FahimAhmad-BD/duccky/analysis/mass/mass_report.md

| Group | Mass (g) |
|---|---|
| servo | 300 |
| printed | 267 |
| allocation | 165 |
| cell | 92 |
| spring | 6 |
| **Total** | **831** |

| Link | Mass (g) |
|---|---|
| trunk | 385.3 |
| head | 81.5 |
| head_pitch_link | 49.9 |
| L_foot | 35.8 |
| R_foot | 35.8 |
| L_hip_roll_link | 32.2 |
| R_hip_roll_link | 32.2 |
| L_thigh | 31.3 |
| R_thigh | 31.3 |
| head_yaw_link | 24.9 |
| L_hip_yaw_link | 24.2 |
| R_hip_yaw_link | 24.2 |
| L_shank | 13.5 |
| R_shank | 13.5 |
| mandible | 8.0 |
| neck_link | 6.9 |

| Printed part | Solid (g) | Printed (g) |
|---|---|---|
| head_shell | 51.5 | 51.5 |
| trunk_frame | 47.5 | 47.5 |
| cartridge_lid | 15.5 | 15.5 |
| cartridge_tray | 15.1 | 15.1 |
| head_base | 13.9 | 13.9 |
| foot_L | 13.0 | 12.8 |
| foot_R | 13.0 | 12.8 |
| shank_L | 10.3 | 10.3 |
| shank_R | 10.3 | 10.3 |
| roll_link_L | 9.2 | 9.2 |
| roll_link_R | 9.2 | 9.2 |
| thigh_L | 8.3 | 8.3 |
| thigh_R | 8.3 | 8.3 |
| neck_mount | 8.2 | 8.2 |
| mandible | 8.0 | 8.0 |
| head_yaw_link | 6.9 | 6.9 |
| yaw_link_L | 6.2 | 6.2 |
| yaw_link_R | 6.2 | 6.2 |
| neck_plate_horn | 3.5 | 3.5 |
| neck_plate_idler | 3.5 | 3.5 |

Total 831 g against 850 g (margin +19 g); centre of mass at x 17.3, y 0.4, z 2.7 mm.
