FahimAhmad-BD/duccky/analysis/harness/harness.md

| Cable | From | To | Joints crossed | Straight (mm) | Service loops (mm) | Cut length (mm) |
|---|---|---|---|---|---|---|
| L1 | carrier J7 (chain 1) | left hip yaw servo | none | 100 | none | 110 |
| L2 | left hip yaw servo | left hip roll servo | hip_yaw | 34 | hip_yaw 12 | 60 |
| L3 | left hip roll servo | left hip pitch servo | hip_roll | 50.7 | hip_roll 9.6 | 75 |
| L4 | carrier J8 (chain 1) | left knee servo | hip_yaw, hip_roll, hip_pitch | 196.7 | hip_yaw 12, hip_roll 9.6, hip_pitch 38.4 | 270 |
| L5 | left knee servo | left ankle servo | knee | 66 | knee 27.6 | 105 |
| R1 | carrier J9 (chain 2) | right hip yaw servo | none | 100 | none | 110 |
| R2 | right hip yaw servo | right hip roll servo | hip_yaw | 34 | hip_yaw 12 | 60 |
| R3 | right hip roll servo | right hip pitch servo | hip_roll | 50.7 | hip_roll 9.6 | 75 |
| R4 | carrier J10 (chain 2) | right knee servo | hip_yaw, hip_roll, hip_pitch | 196.7 | hip_yaw 12, hip_roll 9.6, hip_pitch 38.4 | 270 |
| R5 | right knee servo | right ankle servo | knee | 66 | knee 27.6 | 105 |
| N1 | carrier J11 (chain 3) | neck pitch servo | none | 80 | none | 90 |
| N2 | neck pitch servo | head pitch servo | neck_pitch | 58 | neck_pitch 26.4 | 95 |
| N3 | head pitch servo | head yaw servo | head_pitch | 61.6 | head_pitch 32.4 | 105 |
| N4 | head yaw servo | head roll servo | head_yaw | 34 | head_yaw 69.6 | 115 |
| N5 | head roll servo | beak servo | head_roll | 40 | head_roll 10.8 | 65 |
| HB | carrier J14 | head board | neck_pitch, head_pitch, head_yaw, head_roll | 183.6 | neck_pitch 26.4, head_pitch 32.4, head_yaw 69.6, head_roll 10.8 | 335 |
