FahimAhmad-BD/duccky/ecad/carrier/carrier_iso.png

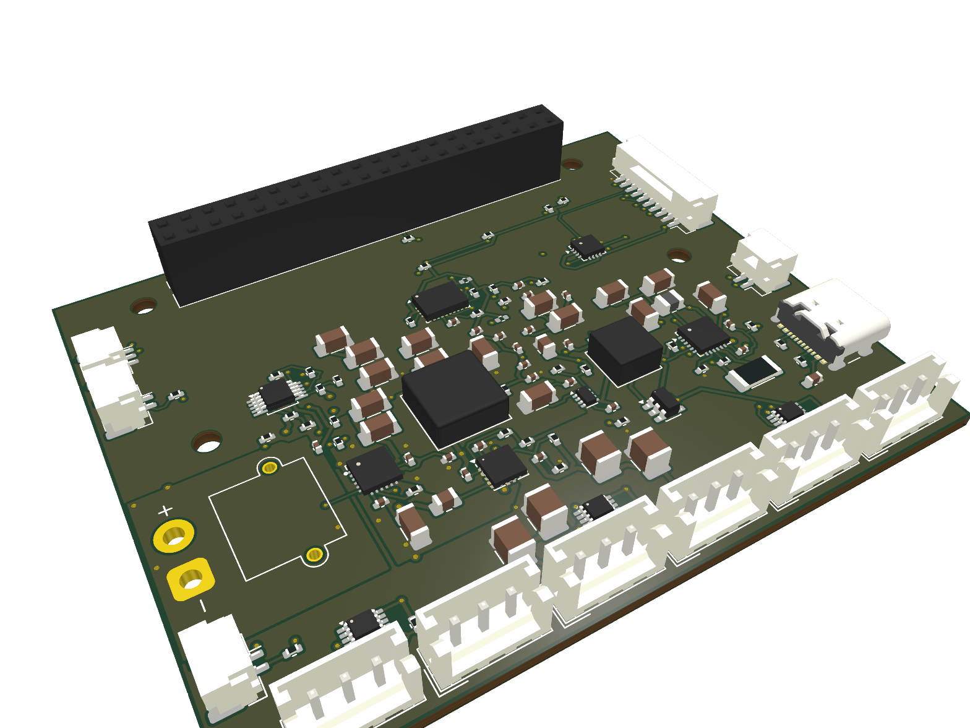
ecad/carrier/carrier_iso.png
