FahimAhmad-BD/duccky/ecad/carrier/carrier_top.png

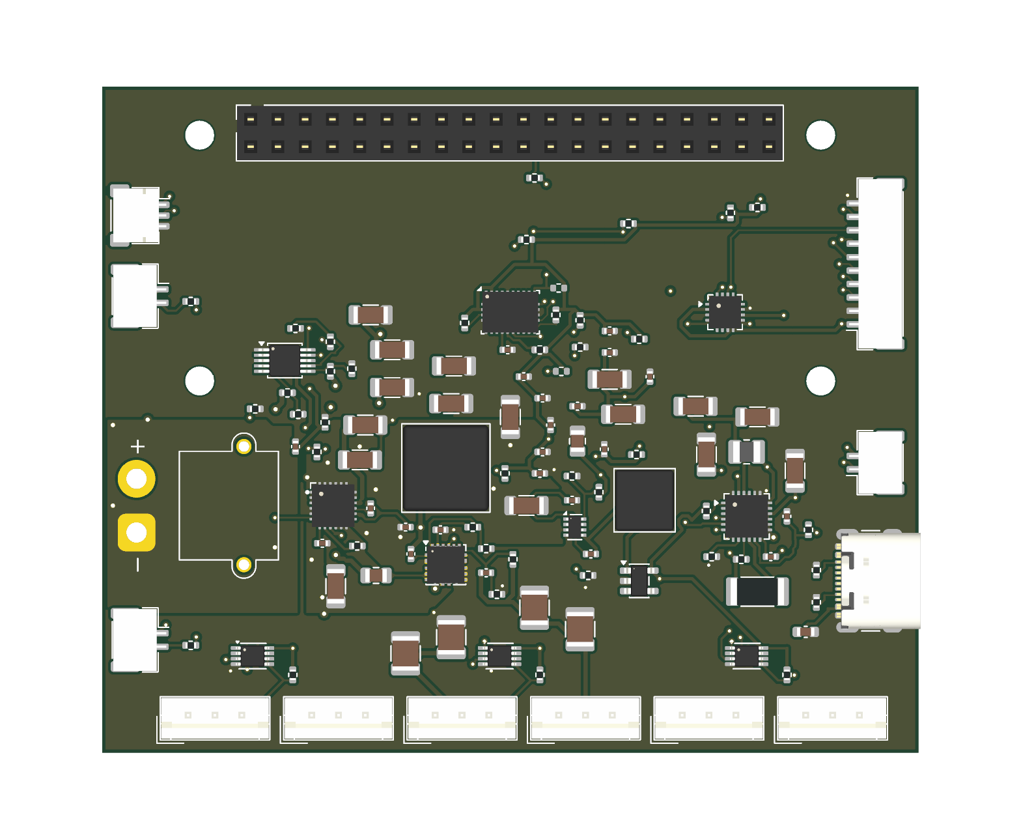
ecad/carrier/carrier_top.png
