FahimAhmad-BD/duccky/ecad/carrier/carrier_mech.step

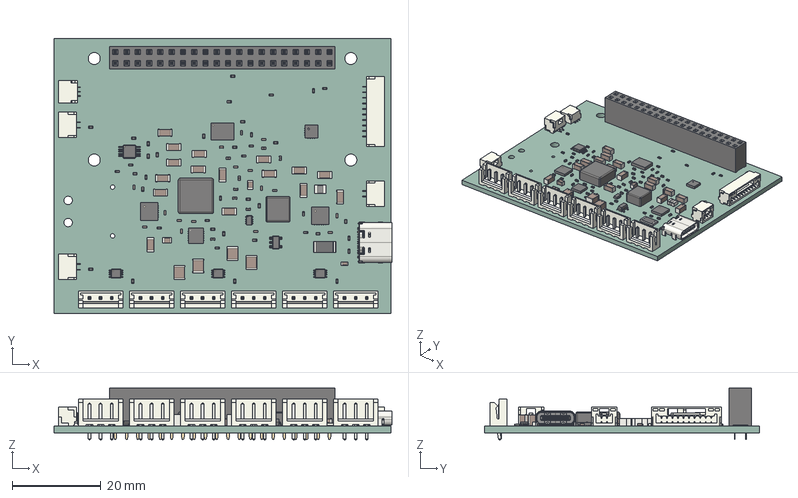
[picture p5: CAD file, 2026-10-10]
ecad/carrier/carrier_mech.step
76.2 x 62.0 x 11.7 mm
C_0402_1005Metric x 22
JST_B3B_EH_A x 6
USB_C_Receptacle_16P_TopMnt_Horizontal_GCT_USB4105-xx-A
C_1206_3216Metric x 16
JST_SM02B_GHS_TB x 3
VSSOP-8_2.3x2mm_P0.5mm x 3
R_0402_1005Metric x 43
C_1210_3225Metric x 4
Texas_RGE0024H_VQFN-24-1EP_4x4mm_P0.5mm_EP2.7x2.7mm
PinSocket_2x20_P2.54mm_Vertical
C_0805_2012Metric x 2
TQFN_16_1EP_3x3mm_P05mm_EP16x16mm
C_0603_1608Metric
LGA_28_52x38mm_P05mm
R_2010_5025Metric
TSSOP-10_3x3mm_P0.5mm
L_Coilcraft_XAL7030-222
SOT-583-8
L_1008_2520Metric
Texas_RGE0024C_VQFN-24-1EP_4x4mm_P0.5mm_EP2.1x2.1mm
SOT-23-5
L_Coilcraft_XAL5030-XXX
JST_SH_SM03B-SRSS-TB_1x03-1MP_P1.00mm_Horizontal
Texas_VQFN_RGR_20_1EP_35x35mm_Pitch05mm
JST_SM10B_GHS_TB
carrier_PCB
