FahimAhmad-BD/duccky/(list of files, cad)

Other CAD files:
ecad/carrier/carrier.step
cad/export/master/duccky_master.f3d
