FahimAhmad-BD/duccky/analysis/sizing/results/A_all_XL330/S1_single_support.csv

crouch_rad | core_hip_yaw | core_hip_roll | core_hip_pitch | core_knee | core_ankle | edge_hip_yaw | edge_hip_roll | edge_hip_pitch | edge_knee | edge_ankle
0.4 | 0.0 | 0.0846 | 0.228 | 0.198 | 0.2223 | 0.0 | 0.1409 | 0.3454 | 0.3154 | 0.3397
0.5 | 0.0 | 0.0846 | 0.2294 | 0.2146 | 0.2223 | 0.0 | 0.1409 | 0.3469 | 0.3321 | 0.3397
0.6 | 0.0 | 0.0846 | 0.2308 | 0.2311 | 0.2223 | 0.0 | 0.1409 | 0.3482 | 0.3485 | 0.3397
0.7 | 0.0 | 0.0846 | 0.2322 | 0.2473 | 0.2223 | 0.0 | 0.1409 | 0.3496 | 0.3647 | 0.3397
0.8 | 0.0 | 0.0846 | 0.2335 | 0.2632 | 0.2223 | 0.0 | 0.1409 | 0.351 | 0.3806 | 0.3397
0.9 | 0.0 | 0.0846 | 0.2348 | 0.2788 | 0.2223 | 0.0 | 0.1409 | 0.3523 | 0.3962 | 0.3397
1.0 | 0.0 | 0.0846 | 0.2361 | 0.294 | 0.2223 | 0.0 | 0.1409 | 0.3536 | 0.4114 | 0.3397
1.1 | 0.0 | 0.0846 | 0.2374 | 0.3088 | 0.2223 | 0.0 | 0.1409 | 0.3548 | 0.4262 | 0.3397
1.2 | 0.0 | 0.0846 | 0.2386 | 0.3231 | 0.2223 | 0.0 | 0.1409 | 0.356 | 0.4405 | 0.3397
1.3 | 0.0 | 0.0846 | 0.2397 | 0.337 | 0.2223 | 0.0 | 0.1409 | 0.3572 | 0.4544 | 0.3397
1.4 | 0.0 | 0.0846 | 0.2409 | 0.3503 | 0.2223 | 0.0 | 0.1409 | 0.3583 | 0.4678 | 0.3397
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
