FahimAhmad-BD/duccky/analysis/sizing/results/A_all_XL330/S2_hip_hinge.csv

trunk_pitch_deg | hip_pitch | knee | ankle
0 | 0.0713 | 0.0482 | 0.062
5 | 0.0938 | 0.0256 | 0.0845
10 | 0.1158 | 0.0037 | 0.1065
15 | 0.1368 | 0.0174 | 0.1275
20 | 0.1569 | 0.0375 | 0.1476
25 | 0.1759 | 0.0564 | 0.1665
30 | 0.1935 | 0.0741 | 0.1842
35 | 0.2097 | 0.0903 | 0.2004
40 | 0.2244 | 0.105 | 0.2151
45 | 0.2374 | 0.118 | 0.2281
50 | 0.2487 | 0.1292 | 0.2394
55 | 0.2581 | 0.1386 | 0.2488
60 | 0.2656 | 0.1461 | 0.2563
65 | 0.2711 | 0.1516 | 0.2618
70 | 0.2746 | 0.1551 | 0.2653
75 | 0.276 | 0.1566 | 0.2667
80 | 0.2754 | 0.156 | 0.2661
