FahimAhmad-BD/duccky/analysis/sizing/results/A_all_XL330/S3_head.csv

neck_pitch | head_pitch | head_yaw | head_roll | beak
0.1051 | 0.1105 | 0.0092 | 0.0082 | 0.0079
0.1132 | 0.1185 | 0.0108 | 0.0059 | 0.0056
0.115 | 0.1203 | 0.0119 | 0.0033 | 0.0029
0.1104 | 0.1158 | 0.0123 | 0.0005 | 0.0007
0.0998 | 0.1052 | 0.0121 | 0.0023 | 0.0027
0.0836 | 0.089 | 0.0113 | 0.005 | 0.0054
0.0628 | 0.0681 | 0.0098 | 0.0075 | 0.0078
0.0488 | 0.0526 | 0.0079 | 0.0095 | 0.0098
0.0352 | 0.039 | 0.0055 | 0.0111 | 0.0113
0.0195 | 0.0233 | 0.0028 | 0.012 | 0.0121
0.0431 | 0.0378 | 0.0 | 0.0123 | 0.0124
0.0965 | 0.1183 | 0.0108 | 0.006 | 0.0057
0.0986 | 0.1204 | 0.0119 | 0.0034 | 0.003
0.0943 | 0.1161 | 0.0123 | 0.0006 | 0.0008
0.084 | 0.1058 | 0.0121 | 0.0022 | 0.0026
0.068 | 0.0898 | 0.0113 | 0.0049 | 0.0053
0.0485 | 0.0691 | 0.0099 | 0.0074 | 0.0077
0.0378 | 0.0531 | 0.008 | 0.0094 | 0.0097
0.0242 | 0.0396 | 0.0056 | 0.011 | 0.0112
0.0313 | 0.024 | 0.0029 | 0.012 | 0.0121
0.0584 | 0.0366 | 0.0001 | 0.0123 | 0.0124
0.0836 | 0.0618 | 0.0027 | 0.012 | 0.012
0.0833 | 0.1204 | 0.0118 | 0.0035 | 0.0032
0.0793 | 0.1164 | 0.0123 | 0.0007 | 0.0009
0.0692 | 0.1063 | 0.0122 | 0.0021 | 0.0025
0.0535 | 0.0906 | 0.0114 | 0.0048 | 0.0052
0.0381 | 0.0701 | 0.01 | 0.0073 | 0.0076
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
