FahimAhmad-BD/duccky/analysis/sizing/results/B_all_STS3032/S1_single_support.csv

crouch_rad | core_hip_yaw | core_hip_roll | core_hip_pitch | core_knee | core_ankle | edge_hip_yaw | edge_hip_roll | edge_hip_pitch | edge_knee | edge_ankle
0.4 | 0.0 | 0.0877 | 0.2365 | 0.2053 | 0.2307 | 0.0 | 0.1462 | 0.3584 | 0.3272 | 0.3525
0.5 | 0.0 | 0.0877 | 0.238 | 0.2226 | 0.2307 | 0.0 | 0.1462 | 0.3598 | 0.3445 | 0.3525
0.6 | 0.0 | 0.0877 | 0.2394 | 0.2397 | 0.2307 | 0.0 | 0.1462 | 0.3612 | 0.3615 | 0.3525
0.7 | 0.0 | 0.0877 | 0.2408 | 0.2565 | 0.2307 | 0.0 | 0.1462 | 0.3626 | 0.3783 | 0.3525
0.8 | 0.0 | 0.0877 | 0.2421 | 0.273 | 0.2307 | 0.0 | 0.1462 | 0.364 | 0.3948 | 0.3525
0.9 | 0.0 | 0.0877 | 0.2435 | 0.2891 | 0.2307 | 0.0 | 0.1462 | 0.3653 | 0.411 | 0.3525
1.0 | 0.0 | 0.0877 | 0.2448 | 0.3049 | 0.2307 | 0.0 | 0.1462 | 0.3667 | 0.4267 | 0.3525
1.1 | 0.0 | 0.0877 | 0.2461 | 0.3202 | 0.2307 | 0.0 | 0.1462 | 0.3679 | 0.4421 | 0.3525
1.2 | 0.0 | 0.0877 | 0.2473 | 0.3351 | 0.2307 | 0.0 | 0.1462 | 0.3692 | 0.457 | 0.3525
1.3 | 0.0 | 0.0877 | 0.2485 | 0.3495 | 0.2307 | 0.0 | 0.1462 | 0.3704 | 0.4713 | 0.3525
1.4 | 0.0 | 0.0877 | 0.2497 | 0.3633 | 0.2307 | 0.0 | 0.1462 | 0.3715 | 0.4852 | 0.3525
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
