FahimAhmad-BD/duccky/analysis/sizing/results/B_all_STS3032/S2_hip_hinge.csv

trunk_pitch_deg | hip_pitch | knee | ankle
0 | 0.0748 | 0.0489 | 0.0653
5 | 0.098 | 0.0257 | 0.0885
10 | 0.1206 | 0.0031 | 0.1111
15 | 0.1423 | 0.0186 | 0.1328
20 | 0.163 | 0.0392 | 0.1534
25 | 0.1824 | 0.0587 | 0.1729
30 | 0.2006 | 0.0768 | 0.191
35 | 0.2172 | 0.0935 | 0.2077
40 | 0.2323 | 0.1086 | 0.2227
45 | 0.2456 | 0.1219 | 0.2361
50 | 0.2571 | 0.1334 | 0.2476
55 | 0.2667 | 0.143 | 0.2572
60 | 0.2743 | 0.1506 | 0.2648
65 | 0.2799 | 0.1562 | 0.2704
70 | 0.2834 | 0.1597 | 0.2739
75 | 0.2849 | 0.1612 | 0.2753
80 | 0.2841 | 0.1604 | 0.2746
