FahimAhmad-BD/duccky/analysis/sizing/results/B_all_STS3032/S3_head.csv

neck_pitch | head_pitch | head_yaw | head_roll | beak
0.1071 | 0.1127 | 0.0093 | 0.0083 | 0.0079
0.1154 | 0.121 | 0.0109 | 0.006 | 0.0056
0.1173 | 0.1229 | 0.012 | 0.0033 | 0.0029
0.1128 | 0.1184 | 0.0124 | 0.0005 | 0.0007
0.102 | 0.1076 | 0.0122 | 0.0024 | 0.0027
0.0856 | 0.0912 | 0.0114 | 0.0051 | 0.0054
0.0644 | 0.07 | 0.0099 | 0.0075 | 0.0078
0.0499 | 0.0539 | 0.0079 | 0.0096 | 0.0098
0.0358 | 0.0398 | 0.0055 | 0.0112 | 0.0113
0.0195 | 0.0235 | 0.0028 | 0.0121 | 0.0121
0.0437 | 0.0382 | 0.0 | 0.0124 | 0.0124
0.0981 | 0.1208 | 0.0109 | 0.0061 | 0.0057
0.1003 | 0.123 | 0.012 | 0.0034 | 0.003
0.0961 | 0.1187 | 0.0124 | 0.0006 | 0.0008
0.0856 | 0.1082 | 0.0122 | 0.0022 | 0.0026
0.0694 | 0.092 | 0.0114 | 0.005 | 0.0053
0.0495 | 0.071 | 0.01 | 0.0074 | 0.0077
0.0383 | 0.0545 | 0.008 | 0.0095 | 0.0097
0.0242 | 0.0404 | 0.0056 | 0.0111 | 0.0112
0.0319 | 0.0242 | 0.003 | 0.0121 | 0.0121
0.0596 | 0.037 | 0.0001 | 0.0124 | 0.0124
0.0854 | 0.0628 | 0.0027 | 0.0121 | 0.012
0.0844 | 0.123 | 0.0119 | 0.0036 | 0.0032
0.0805 | 0.119 | 0.0124 | 0.0007 | 0.0009
0.0702 | 0.1088 | 0.0123 | 0.0021 | 0.0025
0.0542 | 0.0928 | 0.0115 | 0.0049 | 0.0052
0.0384 | 0.072 | 0.0101 | 0.0073 | 0.0076
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
