FahimAhmad-BD/duccky/ecad/carrier/carrier_schematic.pdf

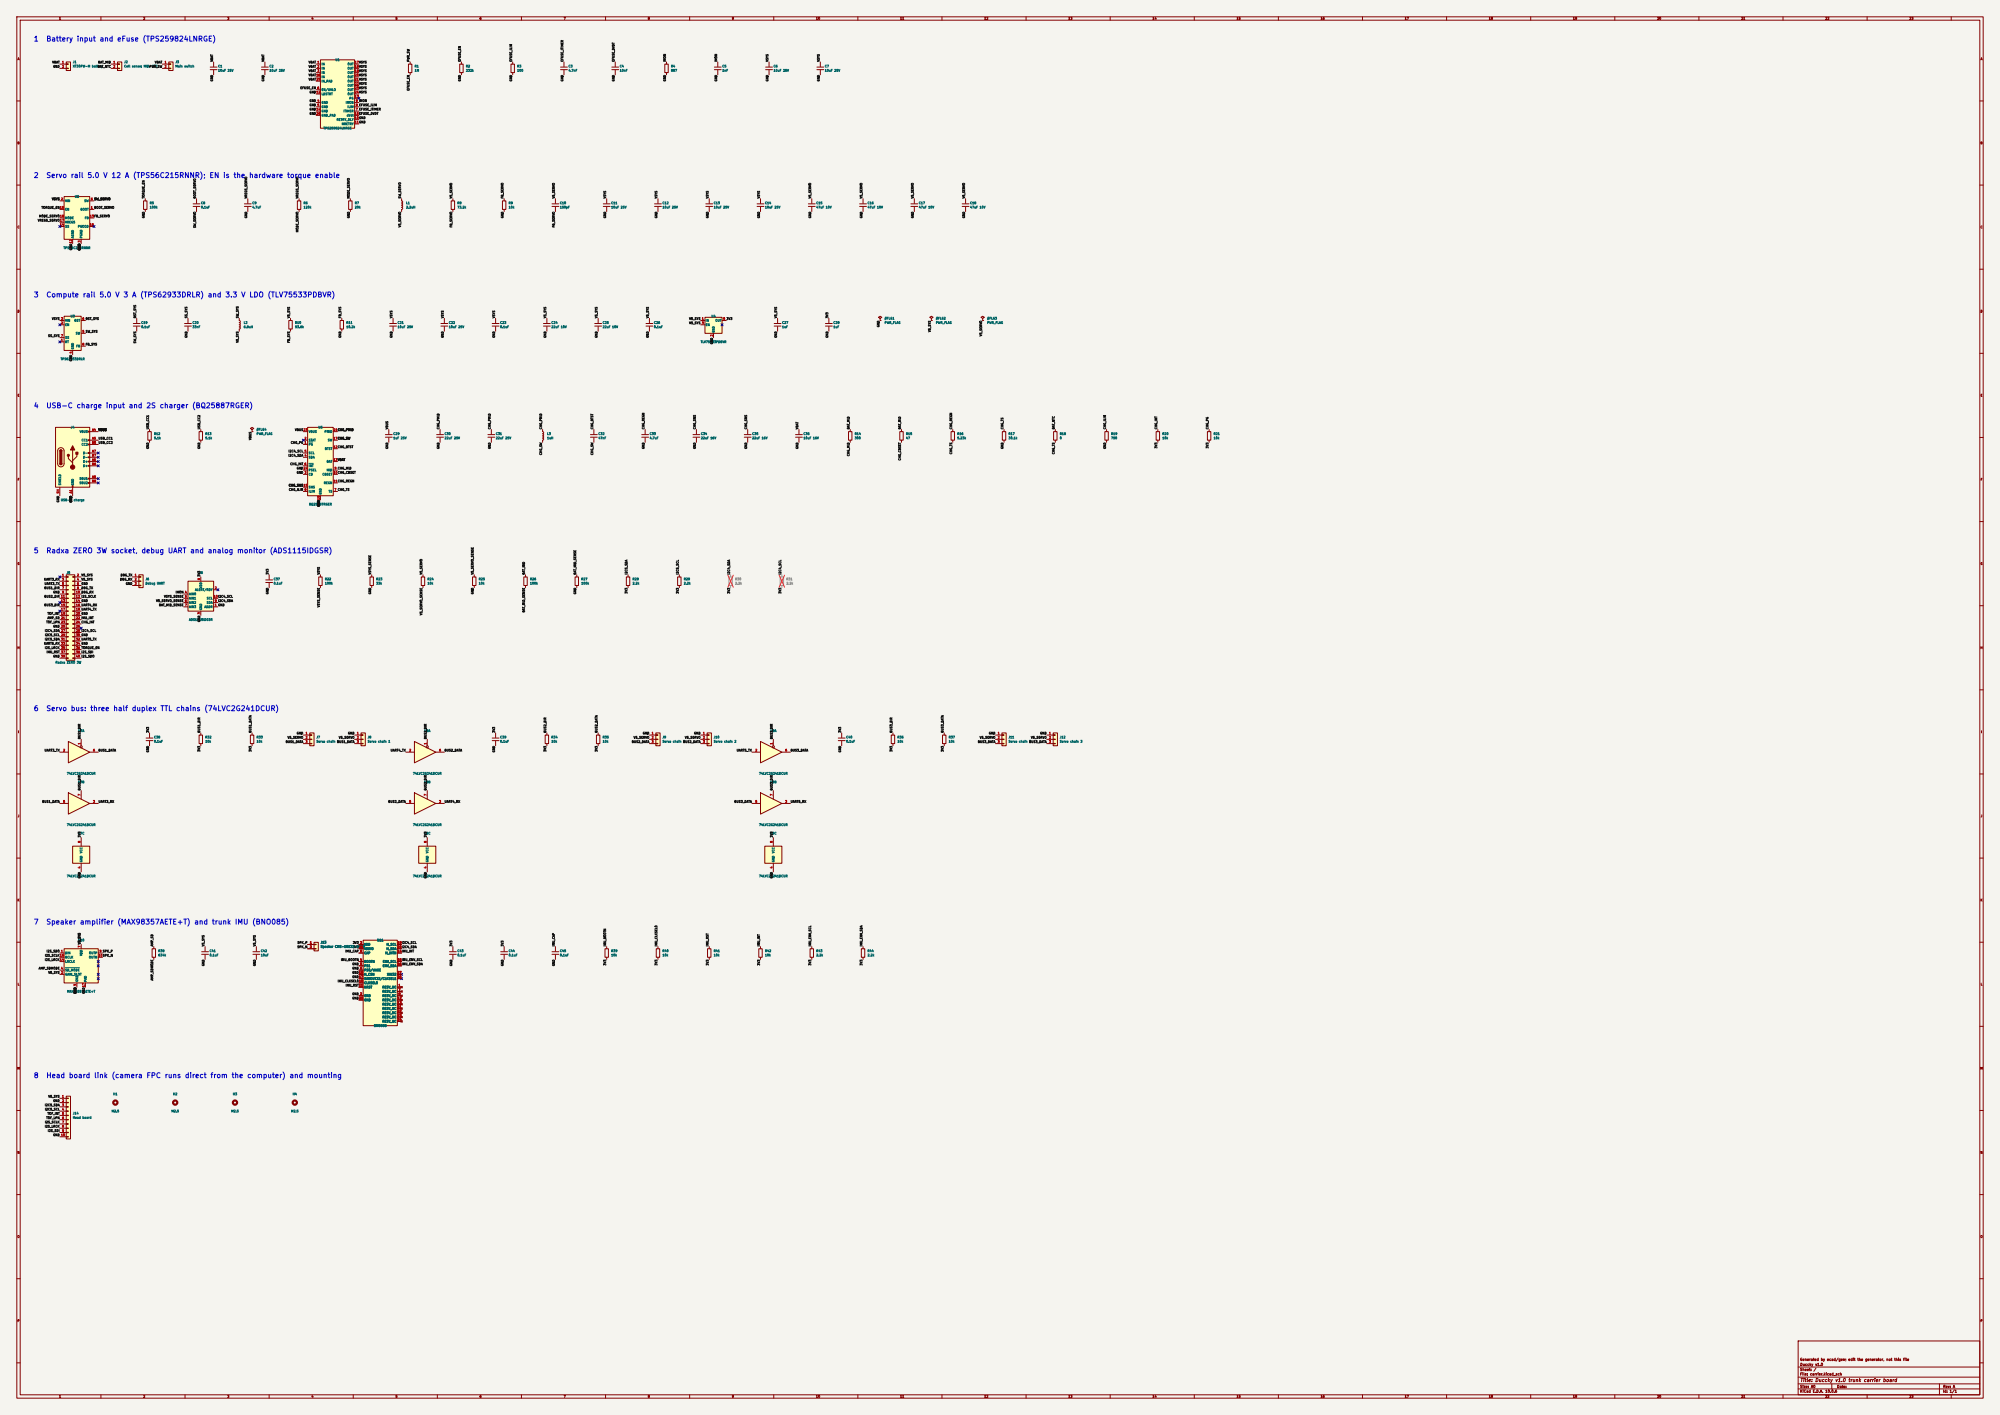
[picture p6: page 1]

1 Battery input and eFuse (TPS259824LNRGE)

VBAT VBAT VBAT VBAT VBAT
GND

2 Servo rail 5.0 V 12 A (TPS56C215RNNR); EN is the hardware torque enable

3 Compute rail 5.0 V 3 A (TPS62933DRLR) and 3.3 V LDO (TLV75533PDBVR)

4 USB-C charge input and 2S charger (BQ25887RGER)

FGH
CHG_SNS 7 Speaker amplifier (MAX98357AETE+T) and trunk IMU (BNO085)

5 Radxa ZERO 3W socket, debug UART and analog monitor (ADS1115IDGSR)
J5 Radxa ZERO 3W

6 Servo bus: three half duplex TTL chains (74LVC2G241DCUR)

8 Head board link (camera FPC runs direct from the computer) and mounting

Generated by ecad/gen; edit the generator, not this file
Duccky v1.0
Sheet: /
File: carrier.kicad_sch
Title: Duccky v1.0 trunk carrier board

Size: A0 | Rev: A
KiCad E.D.A. 10.0.6 | Id: 1/1
