FahimAhmad-BD/duccky/ecad/carrier/carrier.kicad_pcb

## KiCad design ecad/carrier/carrier.kicad_pcb (2026-10-10)

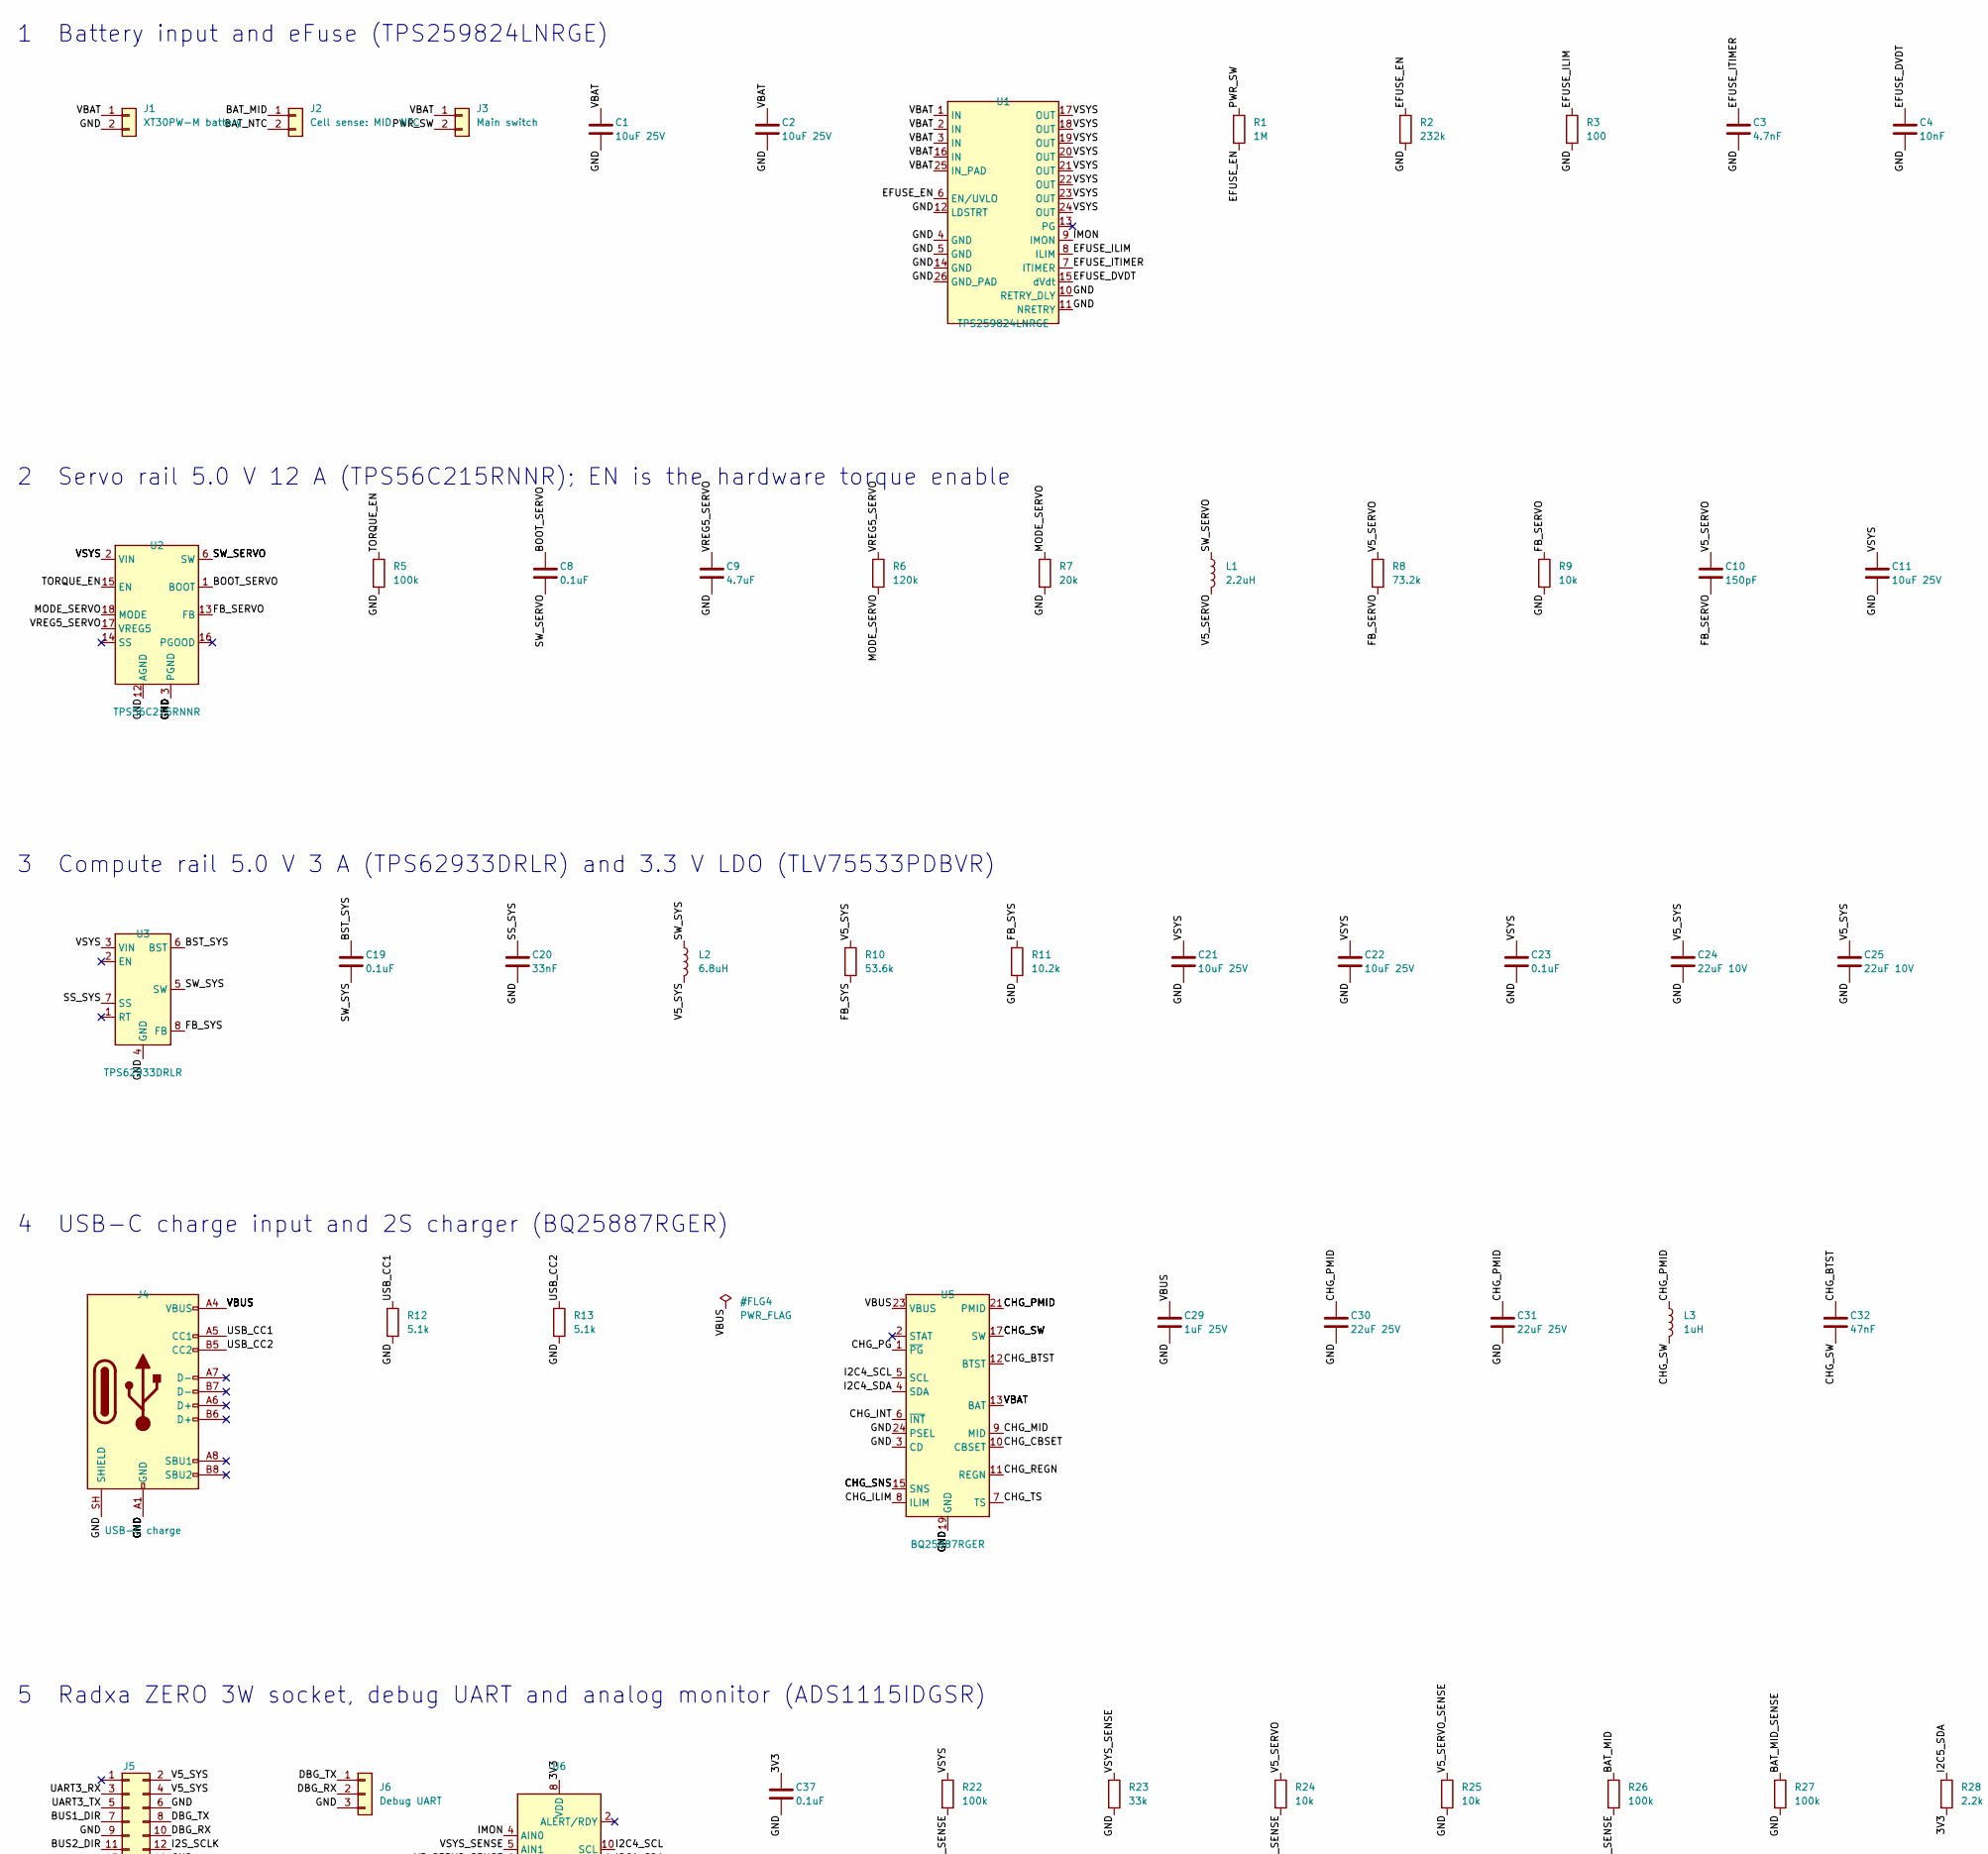
[picture p7: schematic carrier.kicad_sch, Duccky v1.0 trunk carrier board, part in row 1, column 1]

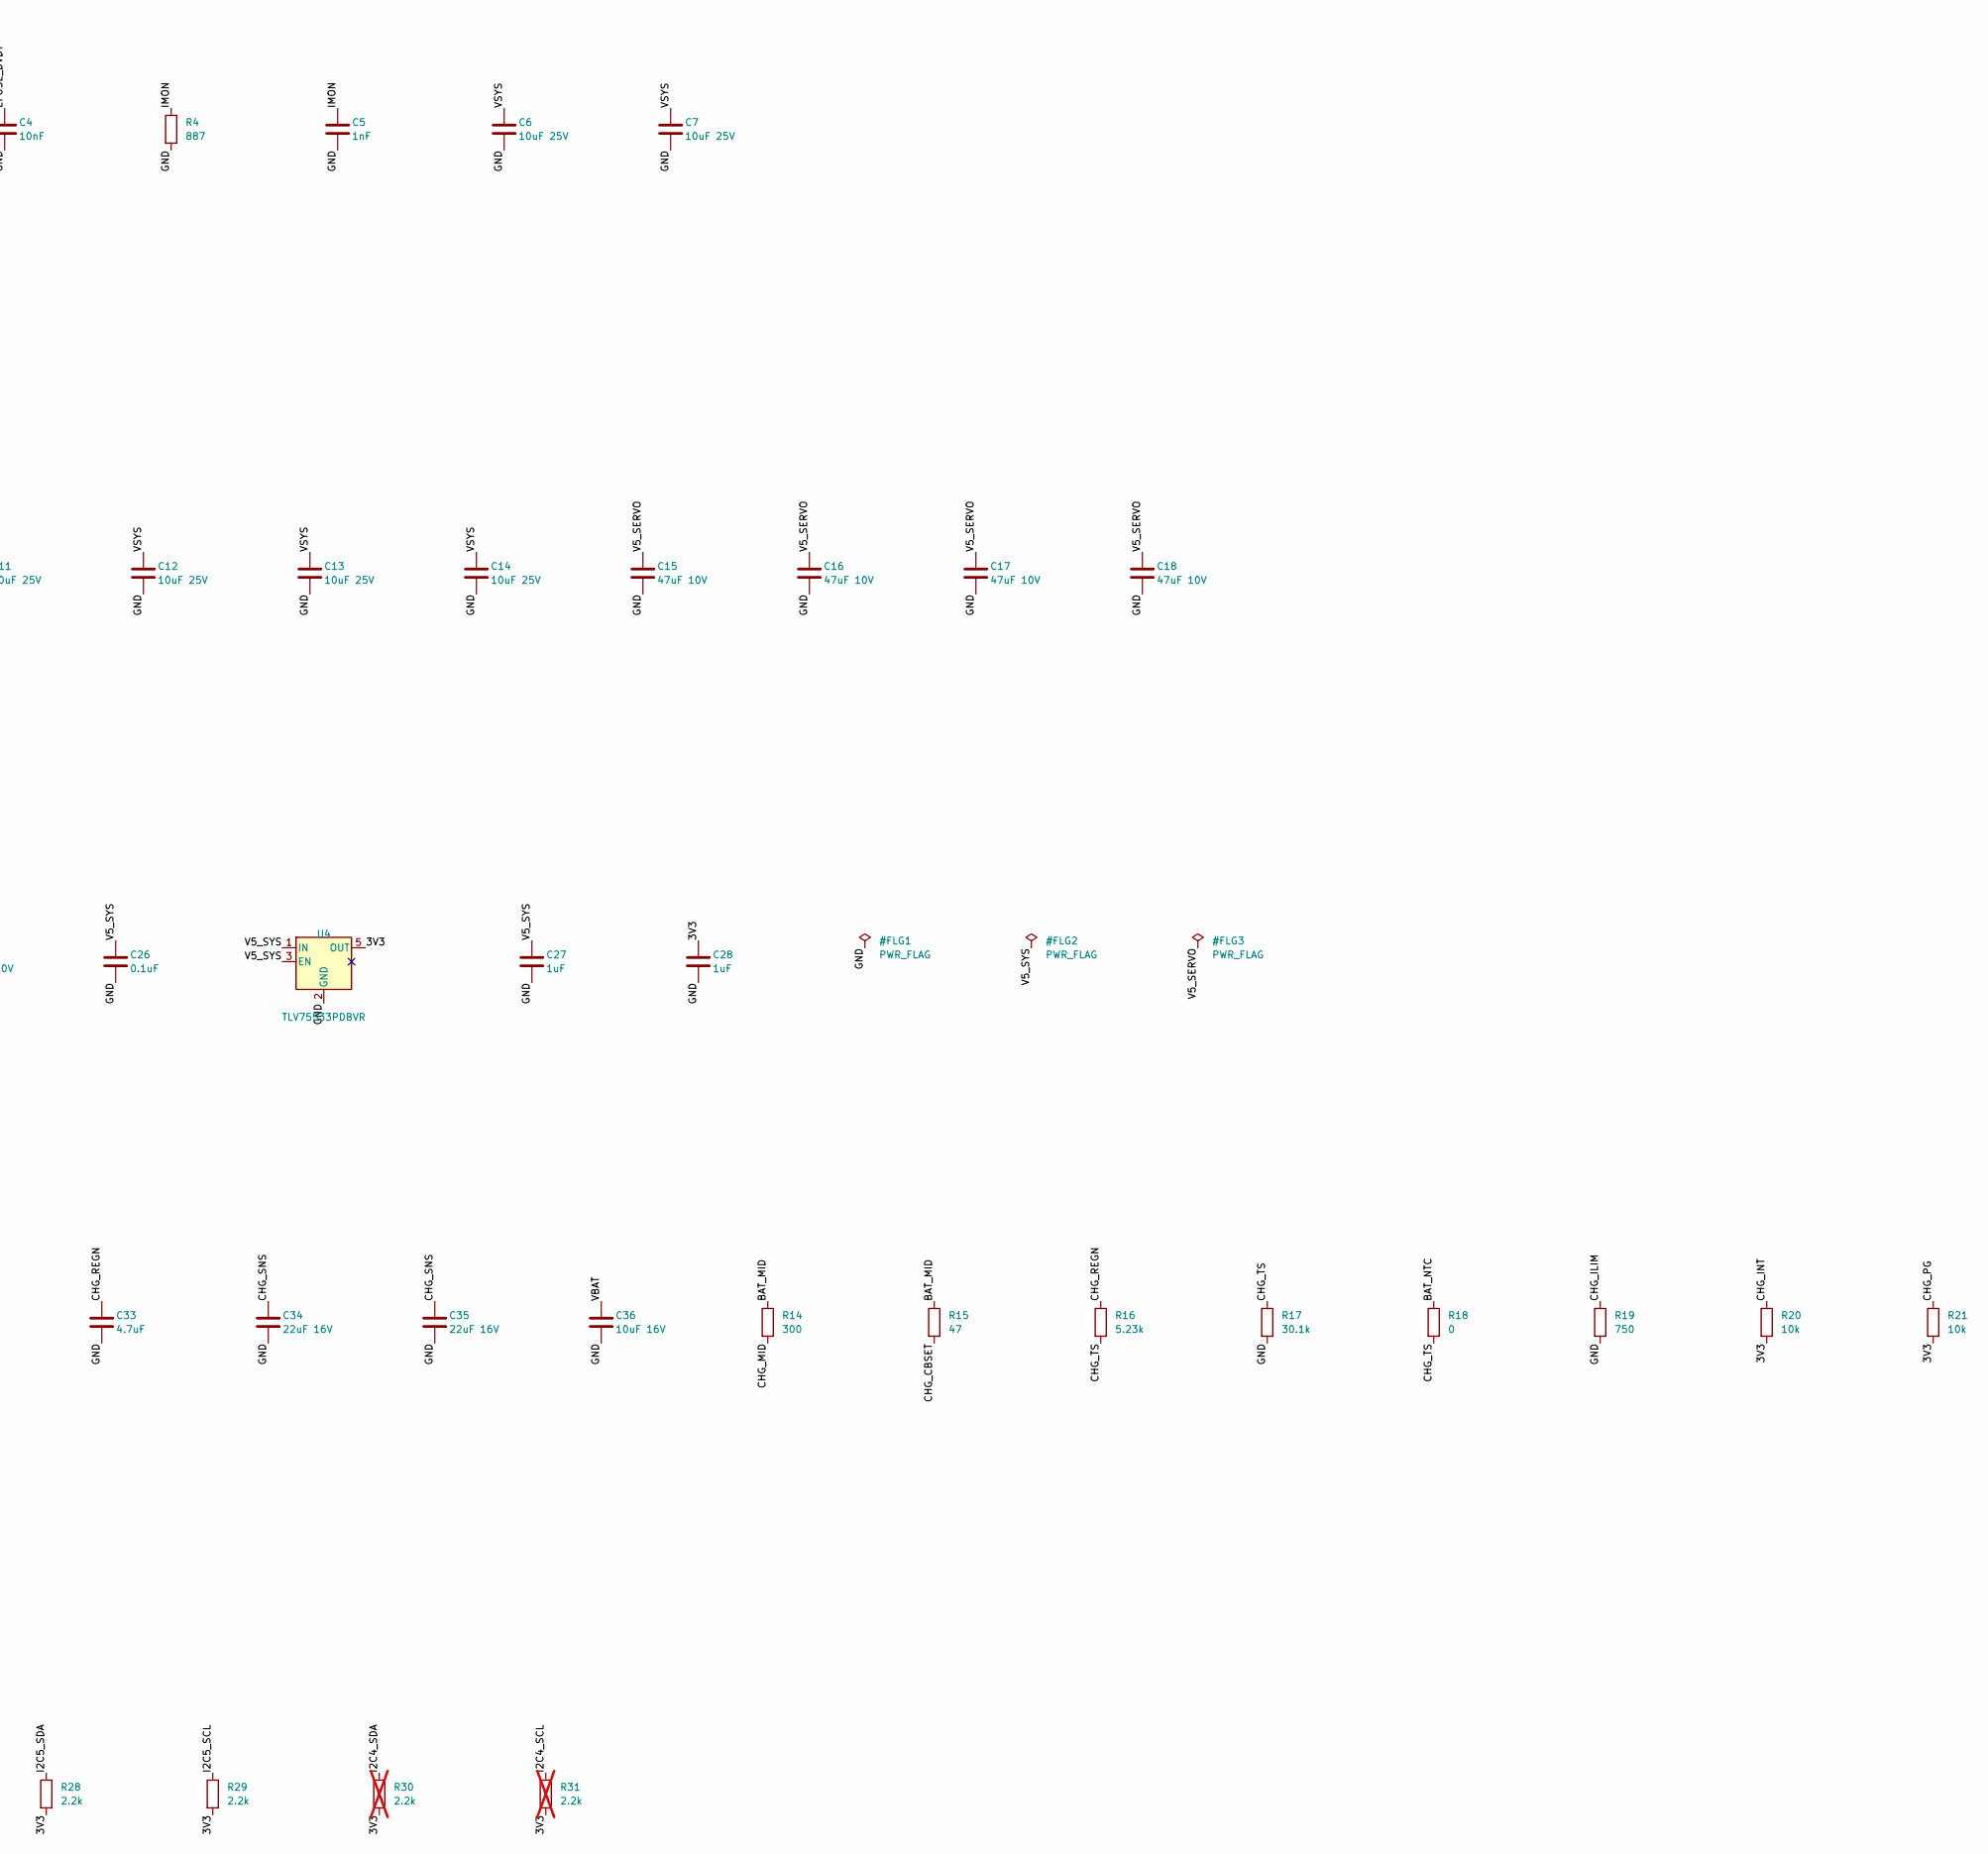
[picture p8: schematic carrier.kicad_sch, Duccky v1.0 trunk carrier board, part in row 1, column 2]

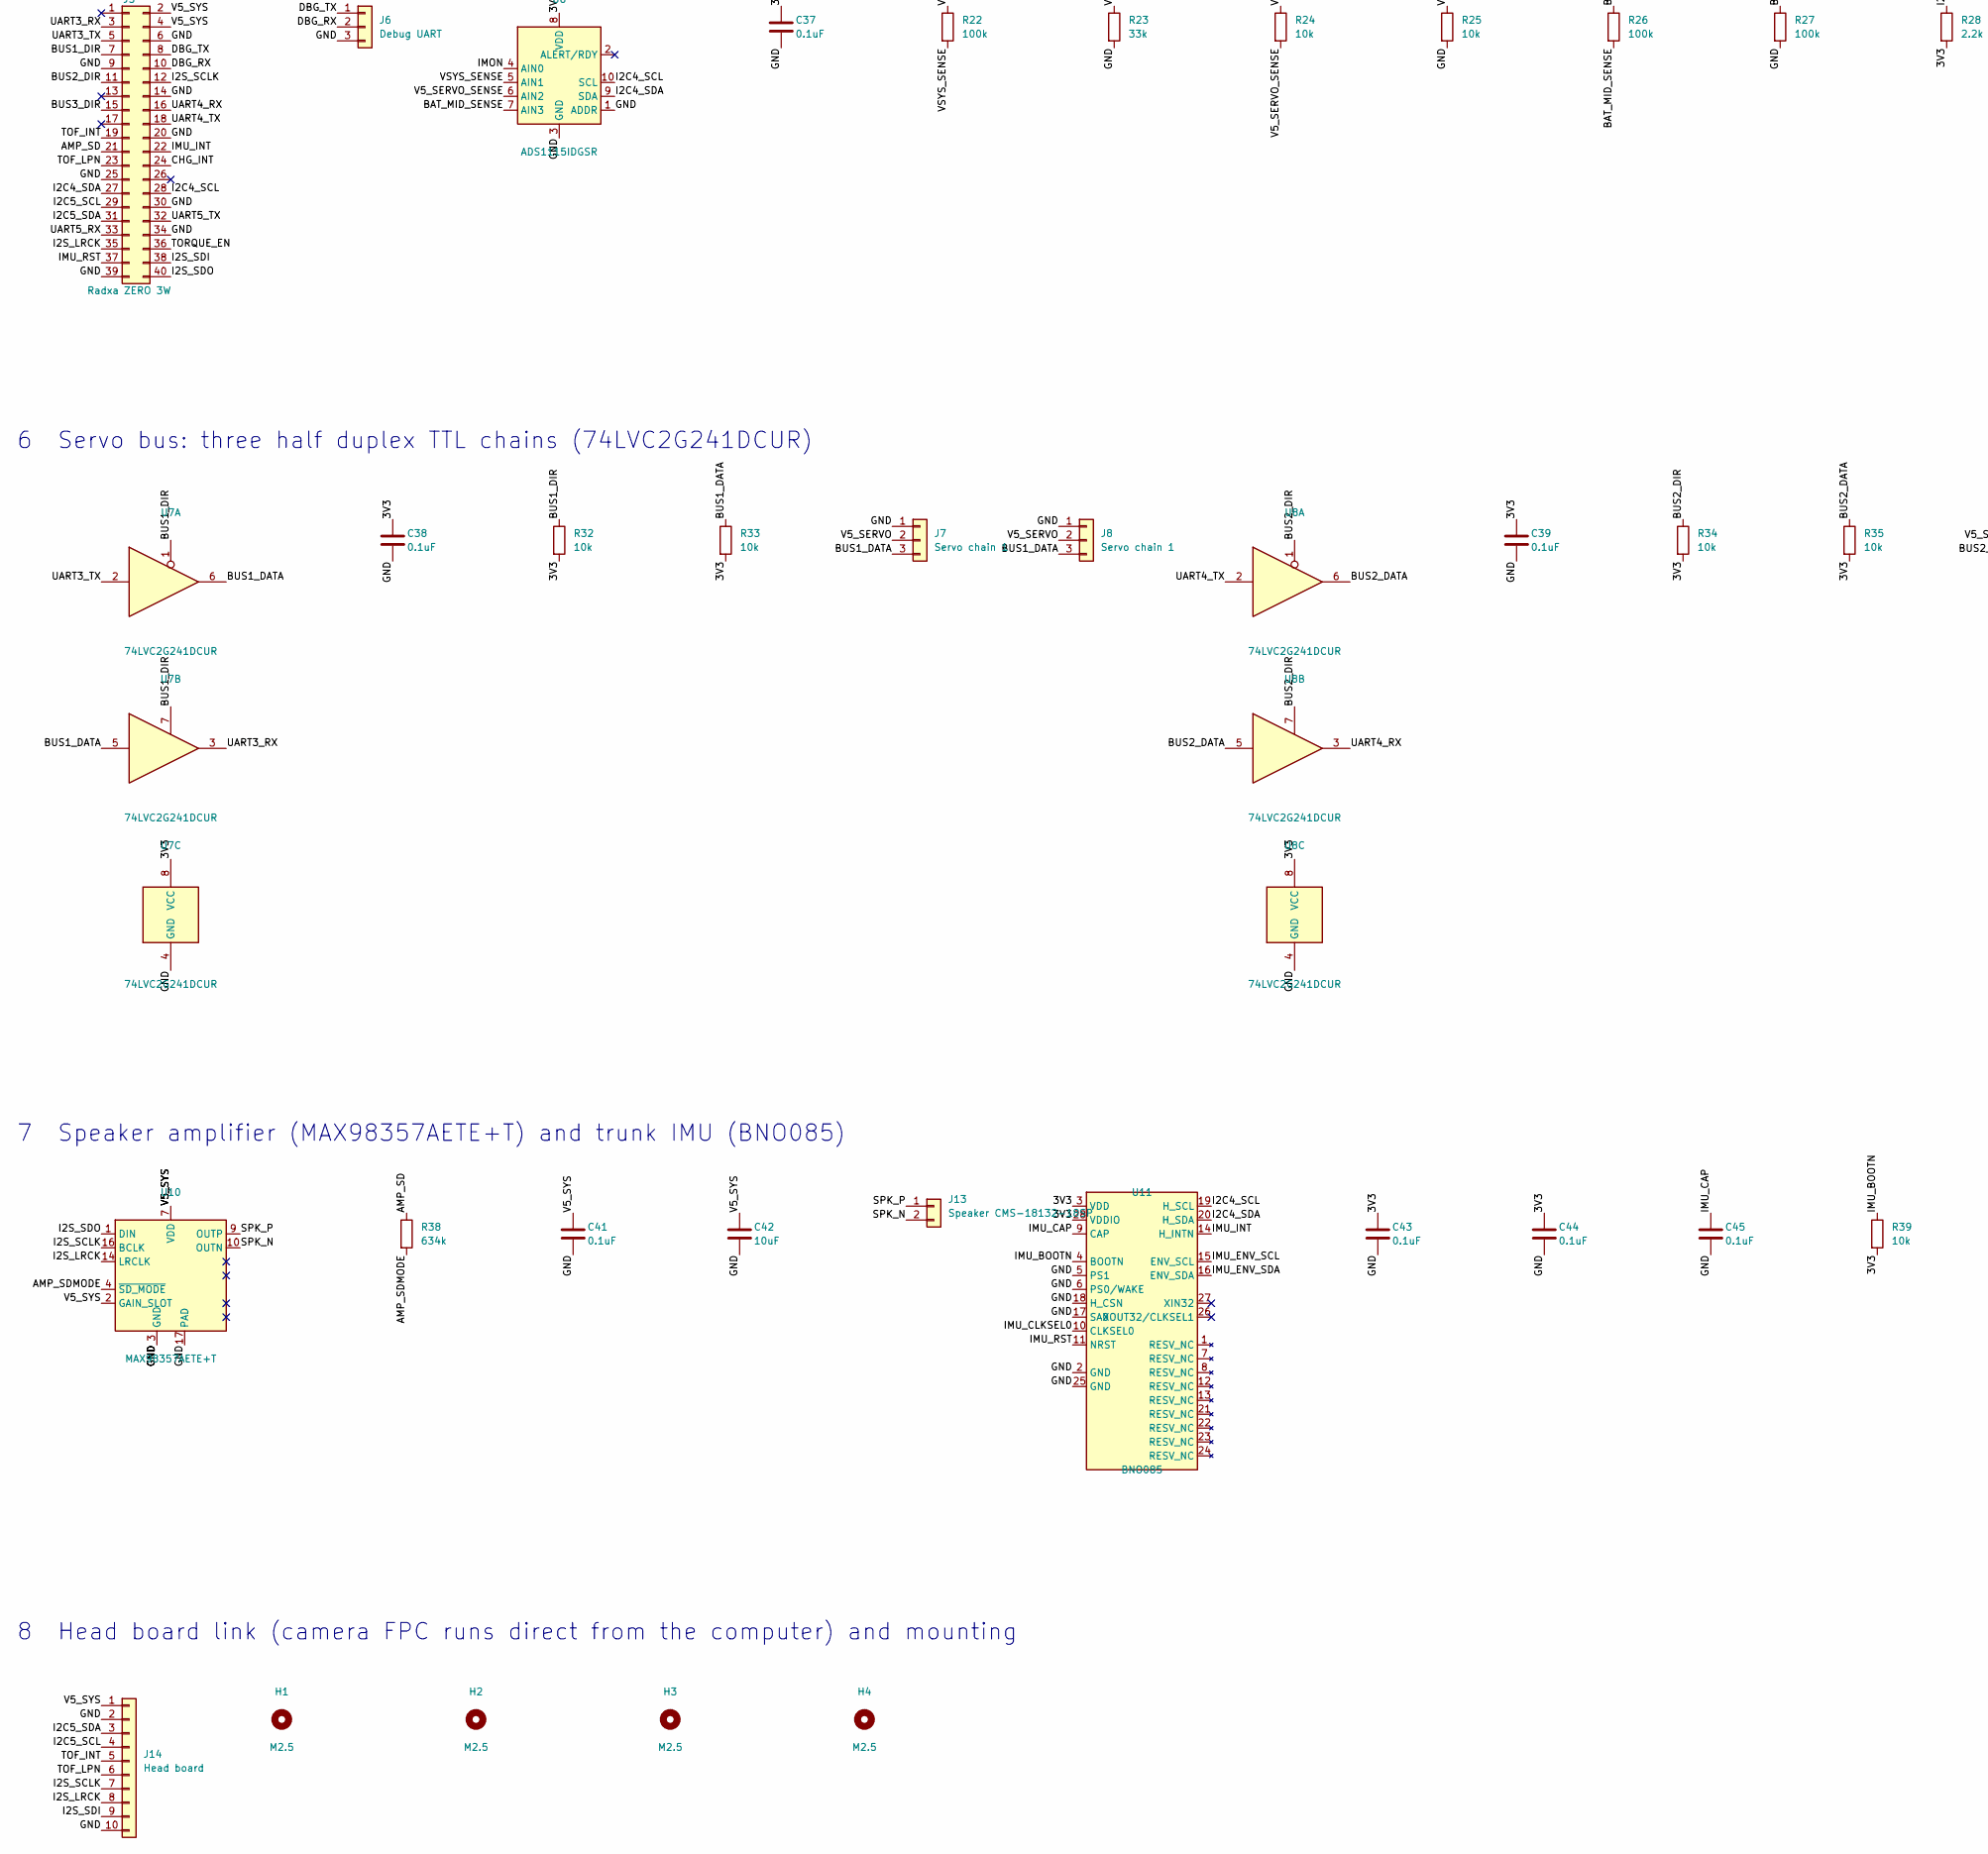
[picture p9: schematic carrier.kicad_sch, Duccky v1.0 trunk carrier board, part in row 2, column 1]

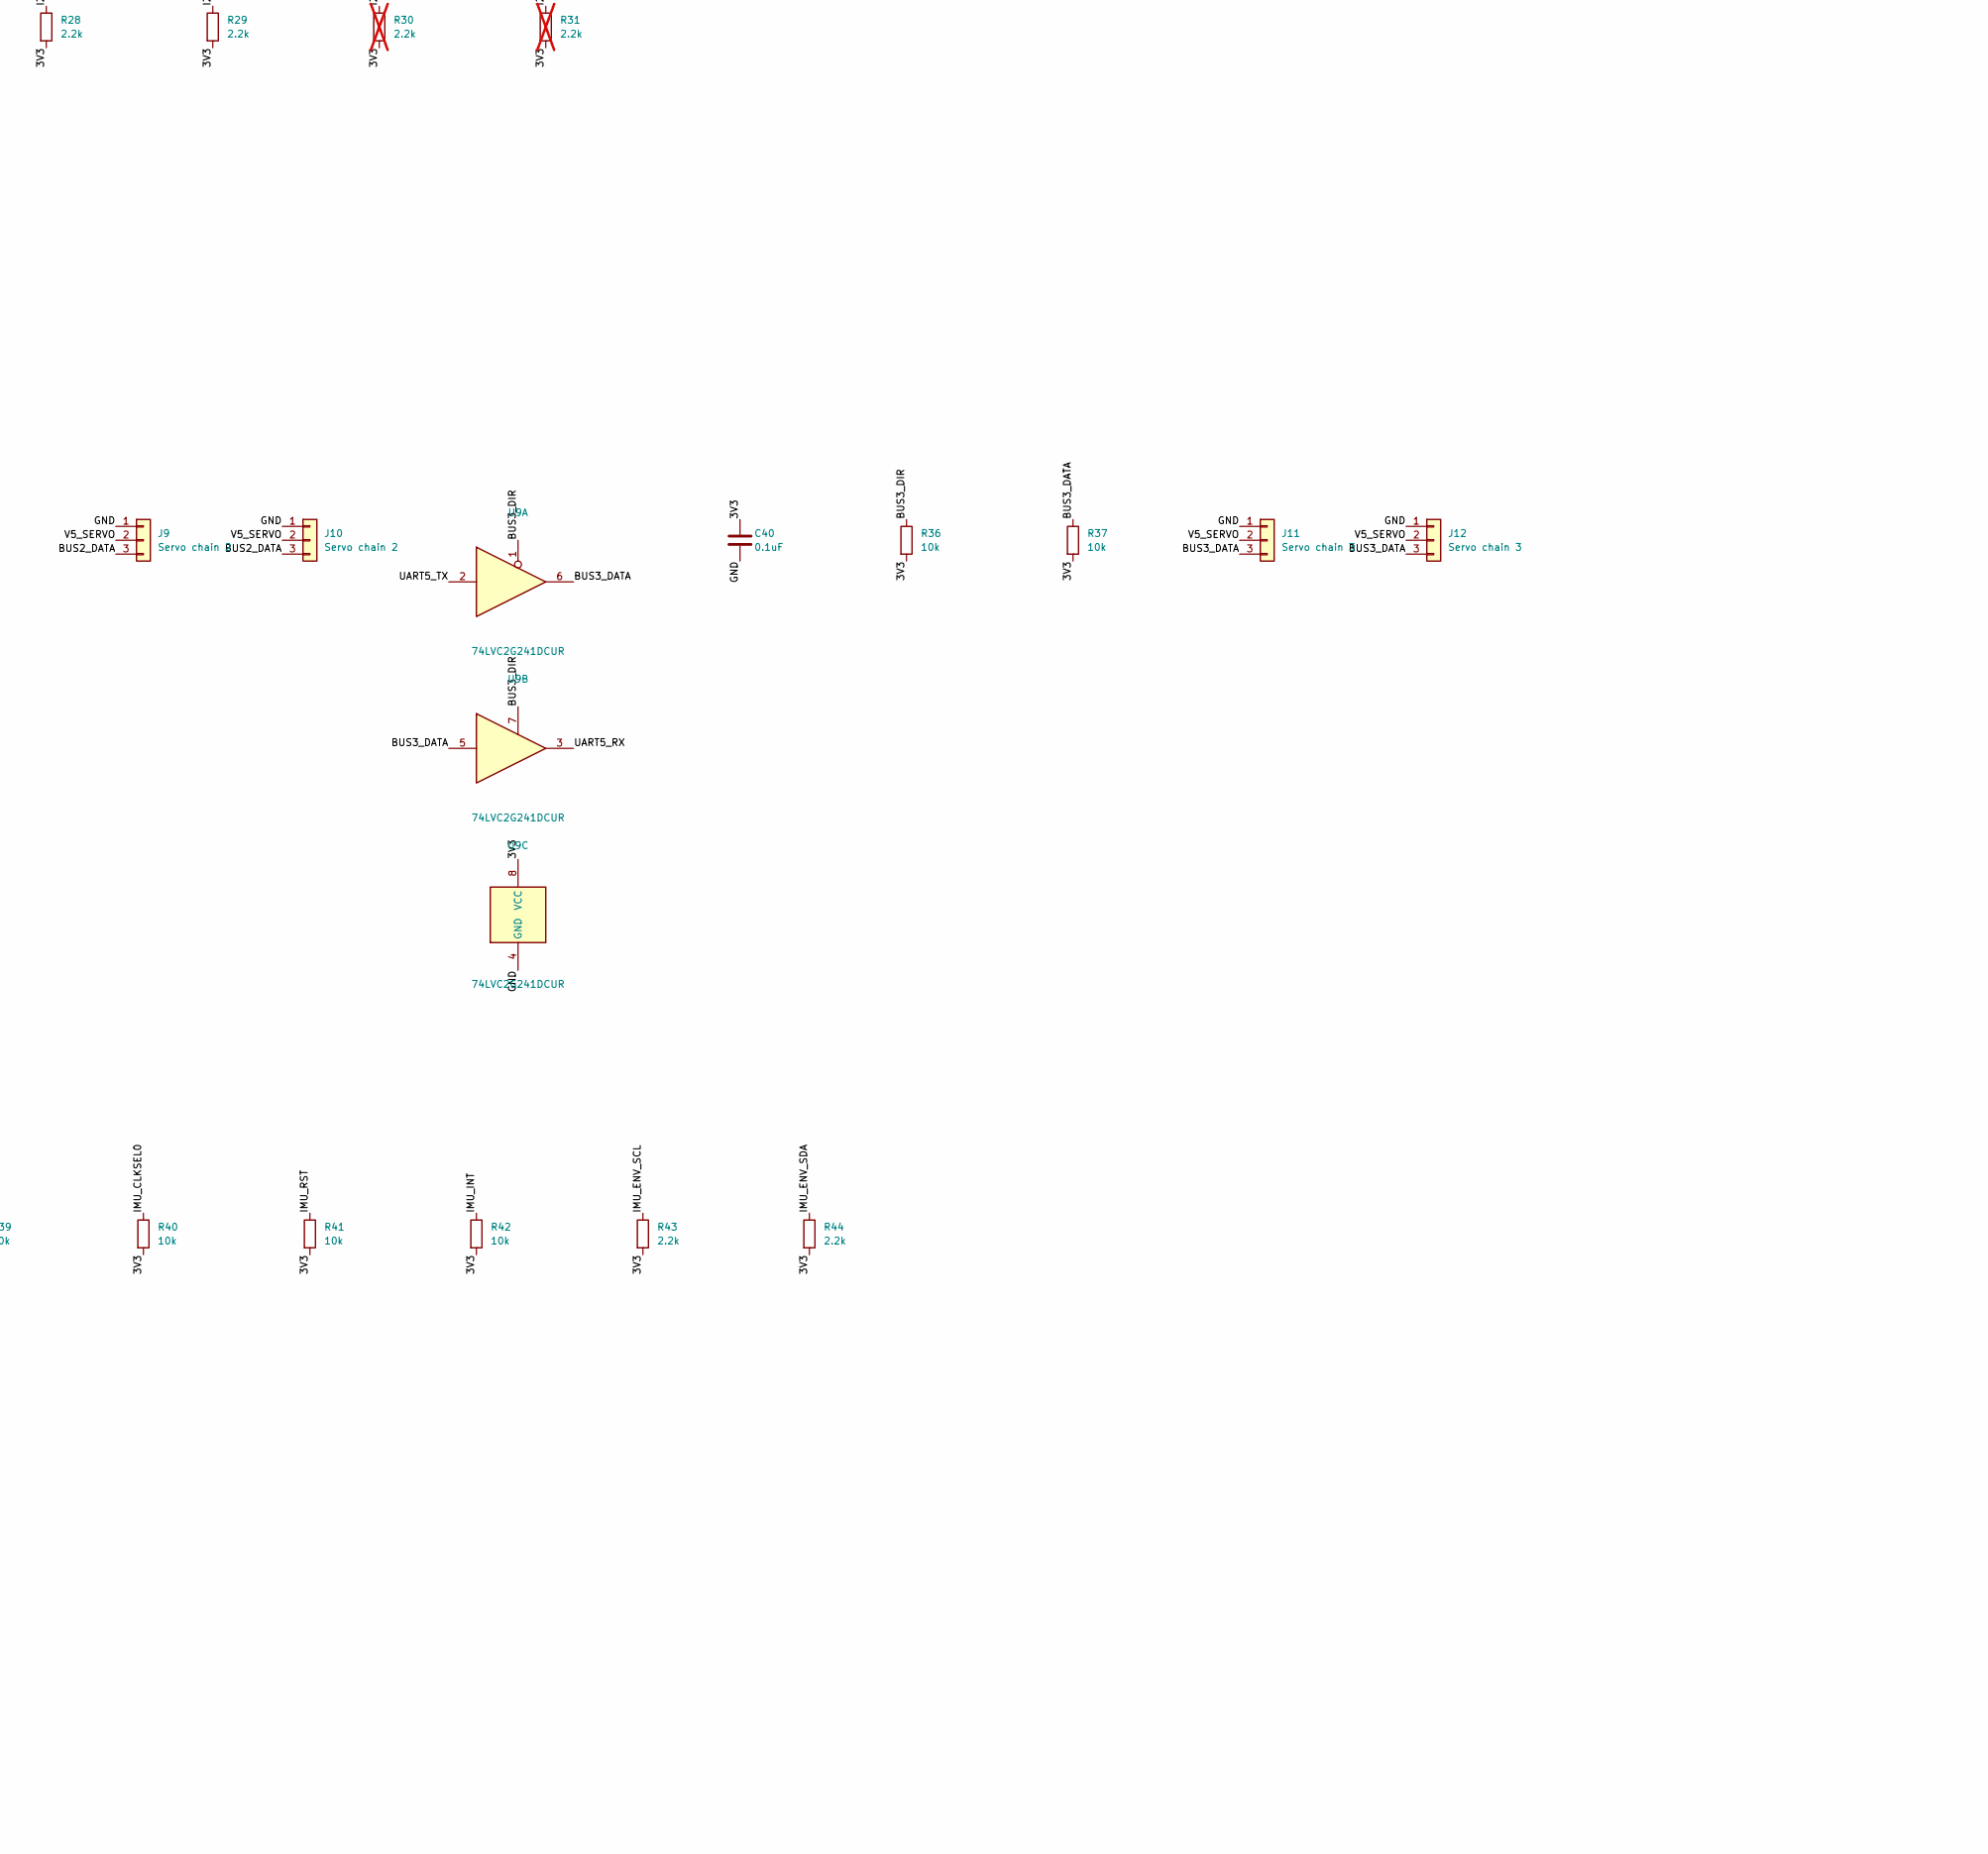
[picture p10: schematic carrier.kicad_sch, Duccky v1.0 trunk carrier board, part in row 2, column 2]

Parts:
C1, C2, C6, C7, C11, C12, C13, C14, C21, C22: 10uF 25V; C_1206_3216Metric
C3: 4.7nF; C_0402_1005Metric
C4: 10nF; C_0402_1005Metric
C5: 1nF; C_0402_1005Metric
C8, C19, C23, C26, C37, C38, C39, C40, C41, C43, C44, C45: 0.1uF; C_0402_1005Metric
C9, C33: 4.7uF; C_0402_1005Metric
C10: 150pF; C_0402_1005Metric
C15, C16, C17, C18: 47uF 10V; C_1210_3225Metric
C20: 33nF; C_0402_1005Metric
C24, C25: 22uF 10V; C_1206_3216Metric
C27, C28: 1uF; C_0402_1005Metric
C29: 1uF 25V; C_0603_1608Metric
C30, C31: 22uF 25V; C_1206_3216Metric
C32: 47nF; C_0402_1005Metric
C34, C35: 22uF 16V; C_1206_3216Metric
C36: 10uF 16V; C_0805_2012Metric
C42: 10uF; C_0805_2012Metric
H1, H2, H3, H4: M2.5; MountingHole_2.7mm_M2.5
J1: XT30PW-M battery; AMASS_XT30PW-M_1x02_P2.50mm_Horizontal; MPN Amass XT30PW-M
J2: Cell sense: MID, NTC; JST_GH_SM02B-GHS-TB_1x02-1MP_P1.25mm_Horizontal; MPN JST SM02B-GHS-TB
J3: Main switch; JST_GH_SM02B-GHS-TB_1x02-1MP_P1.25mm_Horizontal; MPN JST SM02B-GHS-TB
J4: USB-C charge; USB_C_Receptacle_GCT_USB4105-xx-A_16P_TopMnt_Horizontal; MPN GCT USB4105-GF-A
J5: Radxa ZERO 3W; PinSocket_2x20_P2.54mm_Vertical
J6: Debug UART; JST_SH_SM03B-SRSS-TB_1x03-1MP_P1.00mm_Horizontal; MPN JST SM03B-SRSS-TB
J7, J8: Servo chain 1; JST_EH_B3B-EH-A_1x03_P2.50mm_Vertical; MPN JST B3B-EH-A
J9, J10: Servo chain 2; JST_EH_B3B-EH-A_1x03_P2.50mm_Vertical; MPN JST B3B-EH-A
J11, J12: Servo chain 3; JST_EH_B3B-EH-A_1x03_P2.50mm_Vertical; MPN JST B3B-EH-A
J13: Speaker CMS-18132-18SP; JST_GH_SM02B-GHS-TB_1x02-1MP_P1.25mm_Horizontal; MPN JST SM02B-GHS-TB
J14: Head board; JST_GH_SM10B-GHS-TB_1x10-1MP_P1.25mm_Horizontal; MPN JST SM10B-GHS-TB
L1: 2.2uH; L_Coilcraft_XAL7030-222; MPN Coilcraft XAL7030-222
L2: 6.8uH; L_Coilcraft_XAL5030-XXX; MPN 6.8 uH, Isat >= 5.8 A
L3: 1uH; L_1008_2520Metric; MPN Murata DFE252012F-1R0M
R1: 1M; R_0402_1005Metric
R2: 232k; R_0402_1005Metric
R3: 100; R_0402_1005Metric
R4: 887; R_0402_1005Metric
R5, R22, R26, R27: 100k; R_0402_1005Metric
R6: 120k; R_0402_1005Metric
R7: 20k; R_0402_1005Metric
R8: 73.2k; R_0402_1005Metric
R9, R20, R21, R24, R25, R32, R33, R34, R35, R36, R37, R39, R40, R41, R42: 10k; R_0402_1005Metric
R10: 53.6k; R_0402_1005Metric
R11: 10.2k; R_0402_1005Metric
R12, R13: 5.1k; R_0402_1005Metric
R14: 300; R_0402_1005Metric
R15: 47; R_2010_5025Metric
R16: 5.23k; R_0402_1005Metric
R17: 30.1k; R_0402_1005Metric
R18: 0; R_0402_1005Metric
R19: 750; R_0402_1005Metric
R23: 33k; R_0402_1005Metric
R28, R29, R43, R44: 2.2k; R_0402_1005Metric
R30, R31: 2.2k; R_0402_1005Metric; not fitted
R38: 634k; R_0402_1005Metric
U1: TPS259824LNRGE; Texas_RGE0024M_TPS25982
U2: TPS56C215RNNR; Texas_RNN0018A; MPN TPS56C215RNNR
U3: TPS62933DRLR; SOT-583-8; MPN TPS62933DRLR
U4: TLV75533PDBVR; SOT-23-5; MPN TLV75533PDBVR
U5: BQ25887RGER; Texas_RGE0024H_VQFN-24-1EP_4x4mm_P0.5mm_EP2.7x2.7mm; MPN BQ25887RGER
U6: ADS1115IDGSR; TSSOP-10_3x3mm_P0.5mm; MPN ADS1115IDGSR
U7, U8, U9: 74LVC2G241DCUR; VSSOP-8_2.3x2mm_P0.5mm; MPN SN74LVC2G241DCUR
U10: MAX98357AETE+T; TQFN-16-1EP_3x3mm_P0.5mm_EP1.23x1.23mm; MPN MAX98357AETE+T
U11: BNO085; LGA-28_5.2x3.8mm_P0.5mm; MPN BNO085

Connections:
/3V3: C28.1, C37.1, C38.1, C39.1, C40.1, C43.1, C44.1, R20.2, R21.2, R28.2, R29.2, R30.2, R31.2, R32.2, R33.2, R34.2, R35.2, R36.2, R37.2, R39.2, R40.2, R41.2, R42.2, R43.2, R44.2, U4.5 (OUT), U6.8 (VDD), U7.8 (VCC), U8.8 (VCC), U9.8 (VCC), U11.3 (VDD), U11.28 (VDDIO)
/AMP_SD: J5.21, R38.1
/AMP_SDMODE: R38.2, U10.4 (~SD_MODE)
/BAT_MID: J2.1, R14.1, R15.1, R26.1
/BAT_MID_SENSE: R26.2, R27.1, U6.7 (AIN3)
/BAT_NTC: J2.2, R18.1
/BOOT_SERVO: C8.1, U2.1 (BOOT)
/BST_SYS: C19.1, U3.6 (BST)
/BUS1_DATA: J7.3, J8.3, R33.1, U7.5, U7.6
/BUS1_DIR: J5.7, R32.1, U7.1, U7.7
/BUS2_DATA: J9.3, J10.3, R35.1, U8.5, U8.6
/BUS2_DIR: J5.11, R34.1, U8.1, U8.7
/BUS3_DATA: J11.3, J12.3, R37.1, U9.5, U9.6
/BUS3_DIR: J5.15, R36.1, U9.1, U9.7
/CHG_BTST: C32.1, U5.12 (BTST)
/CHG_CBSET: R15.2, U5.10 (CBSET)
/CHG_ILIM: R19.1, U5.8 (ILIM)
/CHG_INT: J5.24, R20.1, U5.6 (~INT)
/CHG_MID: R14.2, U5.9 (MID)
/CHG_PG: R21.1, U5.1 (~PG)
/CHG_PMID: C30.1, C31.1, L3.1, U5.21 (PMID), U5.22 (PMID)
/CHG_REGN: C33.1, R16.1, U5.11 (REGN)
/CHG_SNS: C34.1, C35.1, U5.15 (SNS), U5.16 (SNS)
/CHG_SW: C32.2, L3.2, U5.17 (SW), U5.18 (SW)
/CHG_TS: R16.2, R17.1, R18.2, U5.7 (TS)
/DBG_RX: J5.10, J6.2
/DBG_TX: J5.8, J6.1
/EFUSE_DVDT: C4.1, U1.15 (dVdt)
/EFUSE_EN: R1.2, R2.1, U1.6 (EN/UVLO)
/EFUSE_ILIM: R3.1, U1.8 (ILIM)
/EFUSE_ITIMER: C3.1, U1.7 (ITIMER)
/FB_SERVO: C10.2, R8.2, R9.1, U2.13 (FB)
/FB_SYS: R10.2, R11.1, U3.8 (FB)
/GND: C1.2, C2.2, C3.2, C4.2, C5.2, C6.2, C7.2, C9.2, C11.2, C12.2, C13.2, C14.2, C15.2, C16.2, C17.2, C18.2, C20.2, C21.2, C22.2, C23.2, C24.2, C25.2, C26.2, C27.2, C28.2, C29.2, C30.2, C31.2, C33.2, C34.2, C35.2, C36.2, C37.2, C38.2, C39.2, C40.2, C41.2, C42.2, C43.2, C44.2, C45.2, J1.2, J4.A1 (GND), J4.A12 (GND), J4.B1 (GND), J4.B12 (GND), J4.SH (SHIELD), J5.6, J5.9, J5.14, J5.20, J5.25, J5.30, J5.34, J5.39, J6.3, J7.1, J8.1, J9.1, J10.1, J11.1, J12.1, J14.2, J14.10, R2.2, R3.2, R4.2, R5.2, R7.2, R9.2, R11.2, R12.2, R13.2, R17.2, R19.2, R23.2, R25.2, R27.2, U1.4 (GND), U1.5 (GND), U1.10 (RETRY_DLY), U1.11 (NRETRY), U1.12 (LDSTRT), U1.14 (GND), U1.26 (GND_PAD), U2.3 (PGND), U2.4 (PGND), U2.5 (PGND), U2.8 (PGND), U2.9 (PGND), U2.10 (PGND), U2.12 (AGND), U3.4 (GND), U4.2 (GND), U5.3 (CD), U5.19 (GND), U5.20 (GND), U5.24 (PSEL), U5.25 (GND), U6.1 (ADDR), U6.3 (GND), U7.4 (GND), U8.4 (GND), U9.4 (GND), U10.3 (GND), U10.11 (GND), U10.15 (GND), U10.17 (PAD), U11.2 (GND), U11.5 (PS1), U11.6 (PS0/WAKE), U11.17 (SA0), U11.18 (H_CSN), U11.25 (GND)
/I2C4_SCL: J5.28, R31.1, U5.5 (SCL), U6.10 (SCL), U11.19 (H_SCL)
/I2C4_SDA: J5.27, R30.1, U5.4 (SDA), U6.9 (SDA), U11.20 (H_SDA)
/I2C5_SCL: J5.29, J14.4, R29.1
/I2C5_SDA: J5.31, J14.3, R28.1
/I2S_LRCK: J5.35, J14.8, U10.14 (LRCLK)
/I2S_SCLK: J5.12, J14.7, U10.16 (BCLK)
/I2S_SDI: J5.38, J14.9
/I2S_SDO: J5.40, U10.1 (DIN)
/IMON: C5.1, R4.1, U1.9 (IMON), U6.4 (AIN0)
/IMU_BOOTN: R39.1, U11.4 (BOOTN)
/IMU_CAP: C45.1, U11.9 (CAP)
/IMU_CLKSEL0: R40.1, U11.10 (CLKSEL0)
/IMU_ENV_SCL: R43.1, U11.15 (ENV_SCL)
/IMU_ENV_SDA: R44.1, U11.16 (ENV_SDA)
/IMU_INT: J5.22, R42.1, U11.14 (H_INTN)
/IMU_RST: J5.37, R41.1, U11.11 (NRST)
/MODE_SERVO: R6.2, R7.1, U2.18 (MODE)
/PWR_SW: J3.2, R1.1
/SPK_N: J13.2, U10.10 (OUTN)
/SPK_P: J13.1, U10.9 (OUTP)
/SS_SYS: C20.1, U3.7 (SS)
/SW_SERVO: C8.2, L1.1, U2.6 (SW), U2.7 (SW)
/SW_SYS: C19.2, L2.1, U3.5 (SW)
/TOF_INT: J5.19, J14.5
/TOF_LPN: J5.23, J14.6
/TORQUE_EN: J5.36, R5.1, U2.15 (EN)
/UART3_RX: J5.3, U7.3
/UART3_TX: J5.5, U7.2
/UART4_RX: J5.16, U8.3
/UART4_TX: J5.18, U8.2
/UART5_RX: J5.33, U9.3
/UART5_TX: J5.32, U9.2
/USB_CC1: J4.A5 (CC1), R12.1
/USB_CC2: J4.B5 (CC2), R13.1
/V5_SERVO: C10.1, C15.1, C16.1, C17.1, C18.1, J7.2, J8.2, J9.2, J10.2, J11.2, J12.2, L1.2, R8.1, R24.1
/V5_SERVO_SENSE: R24.2, R25.1, U6.6 (AIN2)
/V5_SYS: C24.1, C25.1, C26.1, C27.1, C41.1, C42.1, J5.2, J5.4, J14.1, L2.2, R10.1, U4.1 (IN), U4.3 (EN), U10.2 (GAIN_SLOT), U10.7 (VDD), U10.8 (VDD)
/VBAT: C1.1, C2.1, C36.1, J1.1, J3.1, U1.1 (IN), U1.2 (IN), U1.3 (IN), U1.16 (IN), U1.25 (IN_PAD), U5.13 (BAT), U5.14 (BAT)
/VBUS: C29.1, J4.A4 (VBUS), J4.A9 (VBUS), J4.B4 (VBUS), J4.B9 (VBUS), U5.23 (VBUS)
/VREG5_SERVO: C9.1, R6.1, U2.17 (VREG5)
/VSYS: C6.1, C7.1, C11.1, C12.1, C13.1, C14.1, C21.1, C22.1, C23.1, R22.1, U1.17 (OUT), U1.18 (OUT), U1.19 (OUT), U1.20 (OUT), U1.21 (OUT), U1.22 (OUT), U1.23 (OUT), U1.24 (OUT), U2.2 (VIN), U2.11 (VIN), U3.3 (VIN)
/VSYS_SENSE: R22.2, R23.1, U6.5 (AIN1)

Notes on the sheet:
1 Battery input and eFuse (TPS259824LNRGE)
2 Servo rail 5.0 V 12 A (TPS56C215RNNR); EN is the hardware torque enable
3 Compute rail 5.0 V 3 A (TPS62933DRLR) and 3.3 V LDO (TLV75533PDBVR)
4 USB-C charge input and 2S charger (BQ25887RGER)
5 Radxa ZERO 3W socket, debug UART and analog monitor (ADS1115IDGSR)
6 Servo bus: three half duplex TTL chains (74LVC2G241DCUR)
7 Speaker amplifier (MAX98357AETE+T) and trunk IMU (BNO085)
8 Head board link (camera FPC runs direct from the computer) and mounting

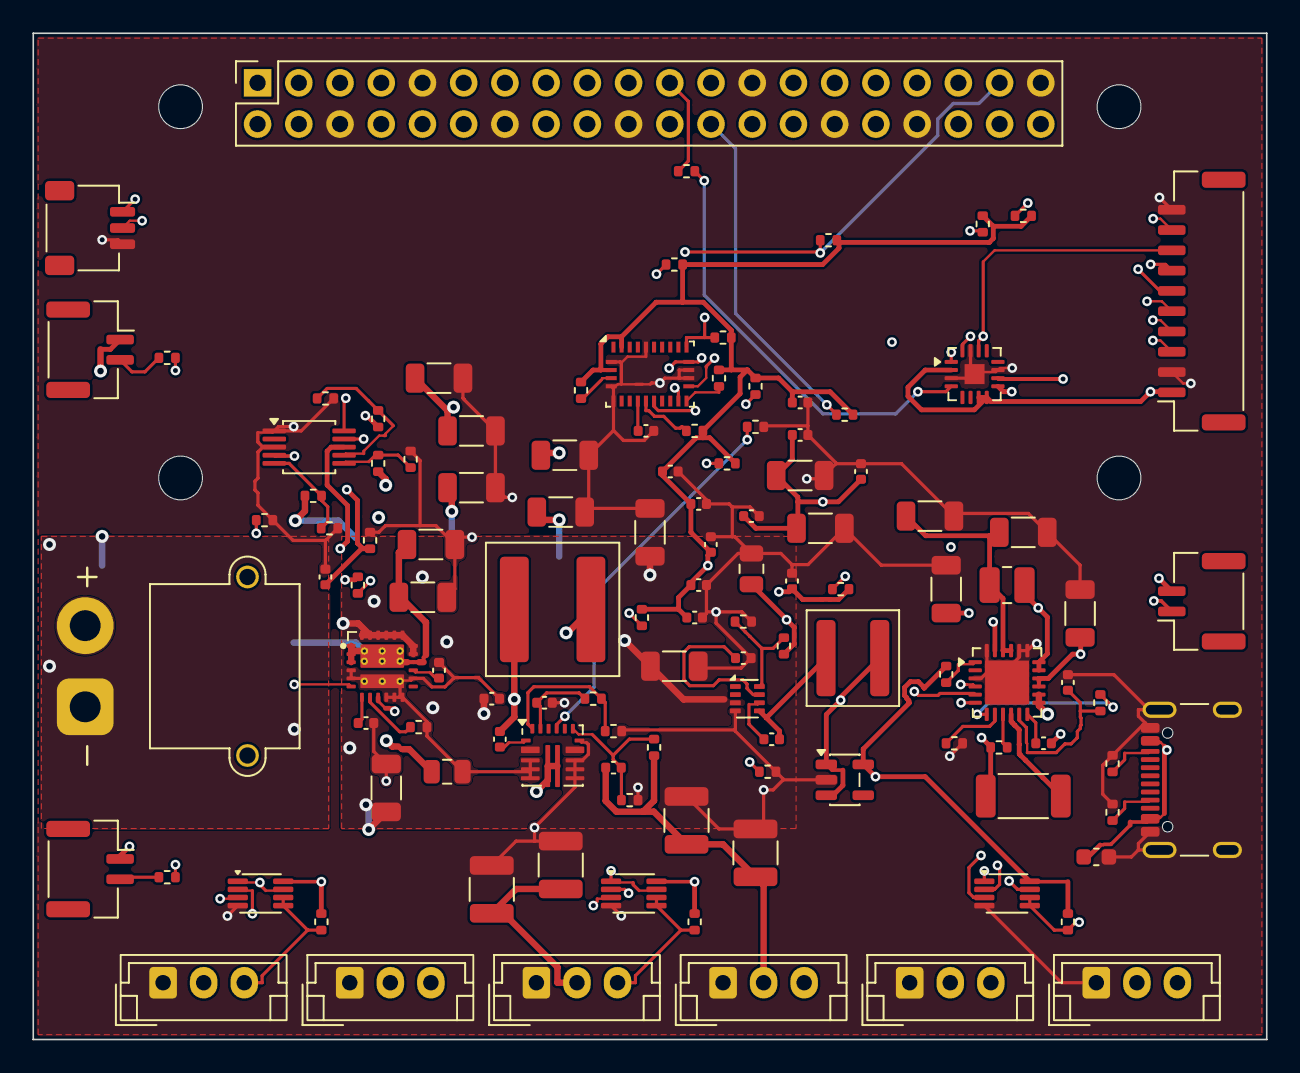
[picture p11: board carrier.kicad_pcb from above]

Board: 4 copper layers, 76.0 x 62.0 mm, 121 parts (0 on the bottom side), 76 nets.
