FahimAhmad-BD/duccky/(commit log)

2026-10-09 Phase 0 and Phase 1: requirements, budgets and actuator sizing study
    [S1_single_support.csv, S2_hip_hinge.csv, S3_head.csv]
2026-10-09 Fix phase references, foot offset comment and head payload comment; record git workflow
    [params.py]
2026-10-10 Phase 2: component selection, power tree, header map; rerun sizing at 825 g
    Battery changes to a 2S Molicel P28A cartridge (no NP-F pack has a
    datasheet). Servo figures confirmed in the ROBOTIS e-Manual (RK4 closed).
    Configuration G still passes; hip pitch walking demand 38.4 % of stall.
    [S1_single_support.csv, S2_hip_hinge.csv]
2026-10-10 Phase 2: generated KiCad carrier schematic, custom symbols and TPS25982 footprint
    Schematic is generated from ecad/gen/carrier.py with values traced to TI,
    CEVA and ADI datasheets. ERC passes with one benign pad-type warning.
    Depth sensor and microphone move to a head board (datasheets pending).
    [carrier.kicad_sch]
2026-10-10 Use the standalone Claude Fusion Bridge add-in; drop Duccky's internal copy
    [carrier.kicad_pcb]
2026-10-10 Phase 2 complete: carrier board PCB, harness, DCK-02 rev A
    - Generated 4-layer 76 x 62 mm carrier PCB: placement, Freerouting, power
    pours and stitching; DRC 0 violations, 0 unconnected, 0 parity issues
    - STEP export for Fusion, renders, end-to-end build script
    - Harness definition from params.py with service loops per joint travel
    - Asset register, CLAUDE.md and README updated; head board deferred (RK9)
    [carrier.kicad_pcb, carrier.kicad_sch, carrier.step]
2026-10-10 Phase 3 start: Fusion helper library and X330 servo reference from the ROBOTIS drawing; close RK10 from Radxa DXF
2026-10-10 Carrier: exact Radxa hole and header positions, 3D body substitutions, iterative dangling cleanup; leg layout study
    [carrier.kicad_pcb, carrier.step]
2026-10-10 Phase 3 leg geometry from servo bodies: offsets, thigh 52, shank 46; sizing rerun passes; harness recomputed
    [S1_single_support.csv, S2_hip_hinge.csv]
2026-10-10 Phase 3: left leg parts in Fusion with zero interference over every joint range
    Yaw link, roll link, thigh, shank and foot built from primitives around the
    X330 references (ROBOTIS drawing) with servo pockets on far-end case holes
    and horn/idler U brackets (FPX330-H101 idlers). Fusion interference analysis
    is clean at the zero pose and at both limits of hip roll, hip pitch, knee and
    ankle. Parts total about 45 g per leg as solid PETG. Roll to pitch offset
    gains the 1 mm running gap (30.7 mm); sizing still passes.
    [S2_hip_hinge.csv]
2026-10-10 Phase 3: whole-robot packaging skeleton (both legs mirrored, cartridge, carrier board STEP) with zero interference; light mechanical board STEP
    [carrier_mech.step]
2026-10-10 Phase 3: trunk frame (floor, deck, walls, standoffs) passes whole-robot interference check; status in CLAUDE.md
2026-10-10 Phase 3: battery cartridge (tray, lid, cell references) fits the trunk with no interference; trunk check job
2026-10-10 Phase 3: neck and head layout with Fusion clearance search; vector head offsets in sizing model; sizing and harness rerun
    [S2_hip_hinge.csv, S3_head.csv]
2026-10-10 Phase 3: neck and head printed parts, all sweeps clear; robot preview job
    Neck mount, two neck plates, head base with yaw collar, yaw link and a hollow
    head shell whose cavity is the roll servo envelope swept over +-0.45 rad and
    which keeps clear of the head base at every yaw and roll pose. Head pitch
    limit -0.8/+1.5 rad from the clearance search. show_robot.py builds the whole
    robot and leaves the document open for viewing.
    [params.py]
2026-10-10 Phase 3 in progress: export to JSON, mass report, beak, knee spring, lightening
    - assembly.py shared by preview and export; export_robot.py writes parts and
    joints to cad/export/robot.json; analysis/mass/mass_report.py
    - Lee Spring LTL048J 04 / LTR048J 04 selected for the knee (0.0989 N m/rad, RK2)
    - beak servo, upper bill and mandible; trunk frame and head shell lightened
    - sizing uses CAD masses: G passes, hip pitch walking 39.6 % before lightening
    [S1_single_support.csv, S2_hip_hinge.csv, S3_head.csv]
2026-10-10 Mandible clear of head base and shell: forward drop arms, front notches, beak 0 to 0.7 rad; beak in assembly and export; save job writes f3d and STEP backups to a Duccky project
2026-10-10 Fusion master archive (f3d), saved 2026-10-10 22:21
    [duccky_master.f3d]
2026-10-10 Mass and sizing from the CAD export with the beak: 831 g (+19 g), config G passes, hip pitch walk 38.9 %; DCK-03 section 6
    [S1_single_support.csv, S2_hip_hinge.csv, S3_head.csv]
